Mario76-soldier/Mario_Keypad/README.md

# Mario_Keypad
This is applicated keypad such as ctrl+c and ctrl+v

## Cloning

This repository uses a git submodule for the key switch footprint library. Clone with:

```sh
git clone --recurse-submodules <this-repo-url>
```

If you already cloned without it:

```sh
git submodule update --init
```

## License

This repository contains code and design files under several licenses.
Each third-party component keeps its own license; the MIT license in [LICENSE](LICENSE) covers only this project's own work.

| Path | License | Copyright / Source |
|---|---|---|
| `Core/`, `USB_DEVICE/`, `STM32F103C8TX_FLASH.ld`, `Keypad.ioc` | [MIT](LICENSE) | © 2026 Mario76-soldier. Includes code generated by STM32CubeMX (© STMicroelectronics). Those files say they follow the LICENSE file in the root directory. |
| `Keypad_PCB/`, `LED.pretty/` | [MIT](LICENSE) | © 2026 Mario76-soldier. The PCB includes footprints from `keyswitches.pretty`, which stay under CC BY-SA 4.0 (see below). |
| `keyswitches.pretty/` (git submodule) | [CC BY-SA 4.0](https://creativecommons.org/licenses/by-sa/4.0/) | © daprice and contributors: <https://github.com/daprice/keyswitches.pretty> |
| `Drivers/STM32F1xx_HAL_Driver/` | [BSD-3-Clause](Drivers/STM32F1xx_HAL_Driver/LICENSE.txt) | © STMicroelectronics |
| `Drivers/CMSIS/Device/ST/` | [Apache-2.0](Drivers/CMSIS/Device/ST/STM32F1xx/LICENSE.txt) | © STMicroelectronics |
| `Drivers/CMSIS/` (Core) | [Apache-2.0](Drivers/CMSIS/LICENSE.txt) | © Arm Limited |
| `Middlewares/ST/STM32_USB_Device_Library/` | [ST Ultimate Liberty License SLA0044](https://www.st.com/SLA0044) | © STMicroelectronics |

### Third-party notices

- **keyswitches.pretty**: Mechanical keyboard switch footprints for KiCad by daprice, licensed under [Creative Commons Attribution-ShareAlike 4.0 International](https://creativecommons.org/licenses/by-sa/4.0/). If you modify and distribute these footprints, you must share them under the same license.
- **STM32Cube HAL / CMSIS / USB Device Library**: Provided by STMicroelectronics and Arm. The USB Device Library (SLA0044) may only be used on STMicroelectronics microcontrollers. See the license headers in each source file.
