Mario76-soldier/Mario_Keypad/Keypad_PCB/Keypad.kicad_pcb

## KiCad design Keypad_PCB/Keypad.kicad_pcb (2026-11-09)

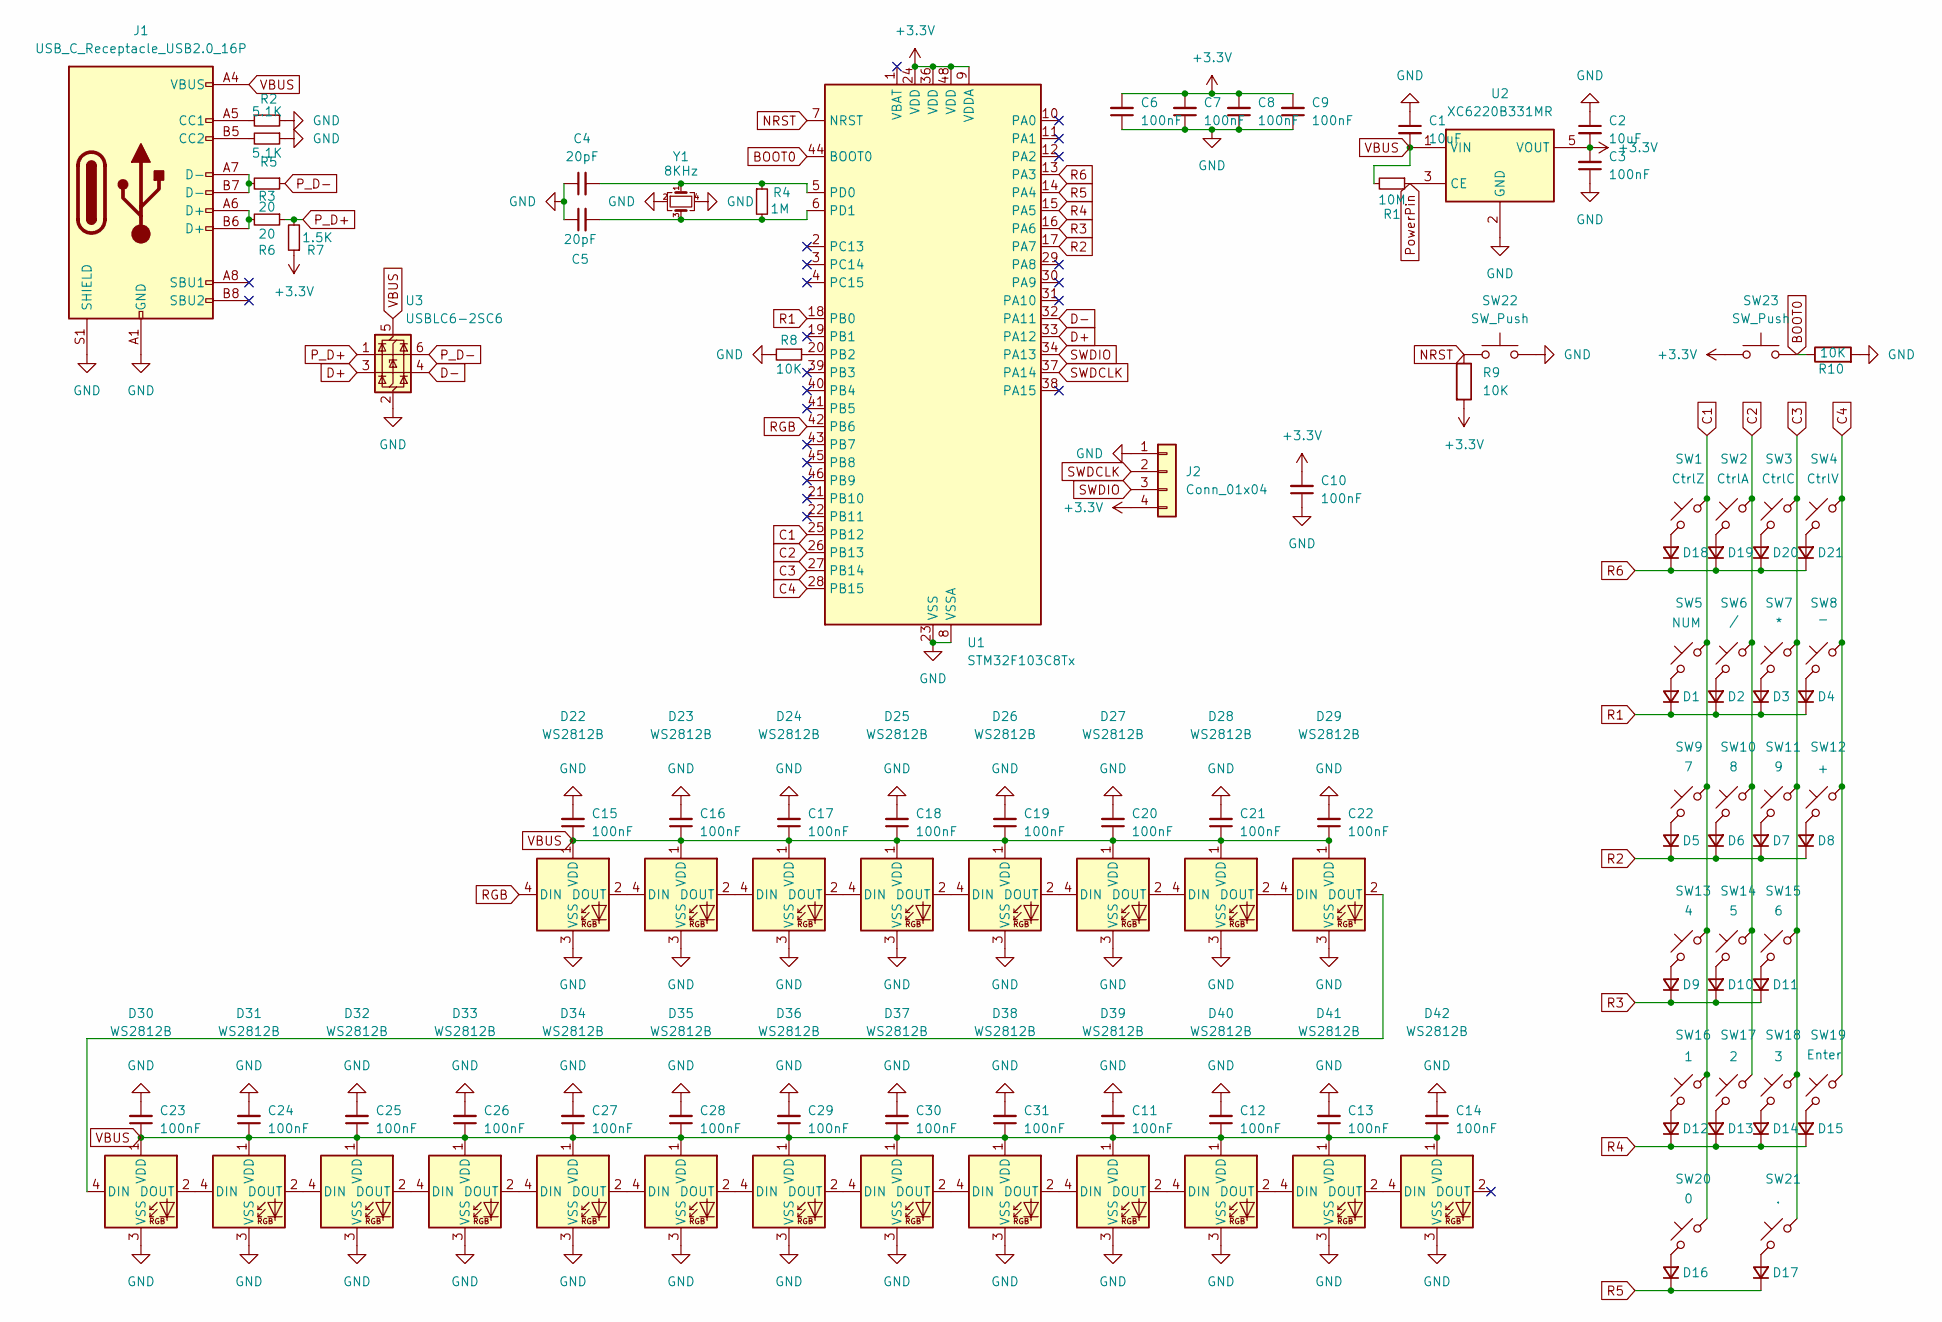
[picture p1: schematic Keypad.kicad_sch]

Parts:
C1, C2: 10uF; C_0603_1608Metric
C3, C6, C7, C8, C9, C10, C11, C12, C13, C14, C15, C16, C17, C18, C19, C20, C21, C22, C23, C24, C25, C26, C27, C28, C29, C30, C31: 100nF; C_0603_1608Metric
C4, C5: 20pF; C_0603_1608Metric
D1, D2, D3, D4, D5, D6, D7, D8, D9, D10, D11, D12, D13, D14, D15, D16, D17, D18, D19, D20, D21: D_Small; D_SOD-123
D22, D23, D24, D25, D26, D27, D28, D29, D30, D31, D32, D33, D34, D35, D36, D37, D38, D39, D40, D41, D42: WS2812B; WS2812_6028
J1: USB_C_Receptacle_USB2.0_16P; USB_C_Receptacle_HCTL_HC-TYPE-C-16P-01A
J2: Conn_01x04; PinHeader_1x04_P2.54mm_Vertical
R1: 10M; R_0603_1608Metric
R2, R3: 5.1K; R_0603_1608Metric
R4: 1M; R_0603_1608Metric
R5, R6: 20; R_0603_1608Metric
R7: 1.5K; R_0603_1608Metric
R8, R9, R10: 10K; R_0603_1608Metric
SW1: CtrlZ; Kailh_socket_MX
SW2: CtrlA; Kailh_socket_MX
SW3: CtrlC; Kailh_socket_MX
SW4: CtrlV; Kailh_socket_MX
SW5: NUM; Kailh_socket_MX
SW6: /; Kailh_socket_MX
SW7: *; Kailh_socket_MX
SW8: -; Kailh_socket_MX
SW9: 7; Kailh_socket_MX
SW10: 8; Kailh_socket_MX
SW11: 9; Kailh_socket_MX
SW12: +; Kailh_socket_MX
SW13: 4; Kailh_socket_MX
SW14: 5; Kailh_socket_MX
SW15: 6; Kailh_socket_MX
SW16: 1; Kailh_socket_MX
SW17: 2; Kailh_socket_MX
SW18: 3; Kailh_socket_MX
SW19: Enter; Kailh_socket_MX
SW20: 0; Kailh_socket_MX
SW21: .; Kailh_socket_MX
SW22, SW23: SW_Push; SW_Push_SPST_NO_Alps_SKRK
U1: STM32F103C8Tx; LQFP-48_7x7mm_P0.5mm
U2: XC6220B331MR; SOT-23-5
U3: USBLC6-2SC6; SOT-23-6
Y1: 8KHz; Crystal_SMD_3225-4Pin_3.2x2.5mm

Connections:
BOOT0: R10.1, SW23.2, U1.44 (BOOT0)
C1: SW1.2, SW5.2, SW9.2, SW13.2, SW16.2, SW20.2, U1.25 (PB12)
C2: SW2.2, SW6.2, SW10.2, SW14.2, SW17.2, U1.26 (PB13)
C3: SW3.2, SW7.2, SW11.2, SW15.2, SW18.2, SW21.2, U1.27 (PB14)
C4: SW4.2, SW8.2, SW12.2, SW19.2, U1.28 (PB15)
D+: U1.33 (PA12), U3.3 (I/O2)
D-: U1.32 (PA11), U3.4 (I/O2)
GND: C1.1, C2.1, C3.1, C4.1, C5.1, C6.1, C7.1, C8.1, C9.1, C10.1, C11.2, C12.2, C13.2, C14.2, C15.2, C16.2, C17.2, C18.2, C19.2, C20.2, C21.2, C22.2, C23.2, C24.2, C25.2, C26.2, C27.2, C28.2, C29.2, C30.2, C31.2, D22.3 (VSS), D23.3 (VSS), D24.3 (VSS), D25.3 (VSS), D26.3 (VSS), D27.3 (VSS), D28.3 (VSS), D29.3 (VSS), D30.3 (VSS), D31.3 (VSS), D32.3 (VSS), D33.3 (VSS), D34.3 (VSS), D35.3 (VSS), D36.3 (VSS), D37.3 (VSS), D38.3 (VSS), D39.3 (VSS), D40.3 (VSS), D41.3 (VSS), D42.3 (VSS), J1.A1 (GND), J1.A12 (GND), J1.B1 (GND), J1.B12 (GND), J1.S1 (SHIELD), J2.1, R2.1, R3.1, R8.2, R10.2, SW22.2, U1.8 (VSSA), U1.23 (VSS), U1.35 (VSS), U1.47 (VSS), U2.2 (GND), U3.2 (GND), Y1.2, Y1.4
NRST: R9.1, SW22.1, U1.7 (NRST)
unnamed: D1.2 (A), SW5.1
unnamed: D2.2 (A), SW6.1
unnamed: D3.2 (A), SW7.1
unnamed: D4.2 (A), SW8.1
unnamed: D5.2 (A), SW9.1
unnamed: D6.2 (A), SW10.1
unnamed: D7.2 (A), SW11.1
unnamed: D8.2 (A), SW12.1
unnamed: D9.2 (A), SW13.1
unnamed: D10.2 (A), SW14.1
unnamed: D11.2 (A), SW15.1
unnamed: D12.2 (A), SW16.1
unnamed: D13.2 (A), SW17.1
unnamed: D14.2 (A), SW18.1
unnamed: D15.2 (A), SW19.1
unnamed: D16.2 (A), SW20.1
unnamed: D17.2 (A), SW21.1
unnamed: D18.2 (A), SW1.1
unnamed: D19.2 (A), SW2.1
unnamed: D20.2 (A), SW3.1
unnamed: D21.2 (A), SW4.1
unnamed: D22.2 (DOUT), D23.4 (DIN)
unnamed: D23.2 (DOUT), D24.4 (DIN)
unnamed: D24.2 (DOUT), D25.4 (DIN)
unnamed: D25.2 (DOUT), D26.4 (DIN)
unnamed: D26.2 (DOUT), D27.4 (DIN)
unnamed: D27.2 (DOUT), D28.4 (DIN)
unnamed: D28.2 (DOUT), D29.4 (DIN)
unnamed: D29.2 (DOUT), D30.4 (DIN)
unnamed: D30.2 (DOUT), D31.4 (DIN)
unnamed: D31.2 (DOUT), D32.4 (DIN)
unnamed: D32.2 (DOUT), D33.4 (DIN)
unnamed: D33.2 (DOUT), D34.4 (DIN)
unnamed: D34.2 (DOUT), D35.4 (DIN)
unnamed: D35.2 (DOUT), D36.4 (DIN)
unnamed: D36.2 (DOUT), D37.4 (DIN)
unnamed: D37.2 (DOUT), D38.4 (DIN)
unnamed: D38.2 (DOUT), D39.4 (DIN)
unnamed: D39.2 (DOUT), D40.4 (DIN)
unnamed: D40.2 (DOUT), D41.4 (DIN)
unnamed: D41.2 (DOUT), D42.4 (DIN)
unnamed: J1.A5 (CC1), R2.2
unnamed: J1.B5 (CC2), R3.2
unnamed: J1.A6 (D+), J1.B6 (D+), R6.2
unnamed: J1.A7 (D-), J1.B7 (D-), R5.2
unnamed: R8.1, U1.20 (PB2)
unnamed: C4.2, R4.1, U1.5 (PD0), Y1.1
unnamed: C5.2, R4.2, U1.6 (PD1), Y1.3
P_D+: R6.1, R7.2, U3.1 (I/O1)
P_D-: R5.1, U3.6 (I/O1)
PowerPin: R1.1, U2.3 (CE)
R1: D1.1 (K), D2.1 (K), D3.1 (K), D4.1 (K), U1.18 (PB0)
R2: D5.1 (K), D6.1 (K), D7.1 (K), D8.1 (K), U1.17 (PA7)
R3: D9.1 (K), D10.1 (K), D11.1 (K), U1.16 (PA6)
R4: D12.1 (K), D13.1 (K), D14.1 (K), D15.1 (K), U1.15 (PA5)
R5: D16.1 (K), D17.1 (K), U1.14 (PA4)
R6: D18.1 (K), D19.1 (K), D20.1 (K), D21.1 (K), U1.13 (PA3)
RGB: D22.4 (DIN), U1.42 (PB6)
SWDCLK: J2.2, U1.37 (PA14)
SWDIO: J2.3, U1.34 (PA13)

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
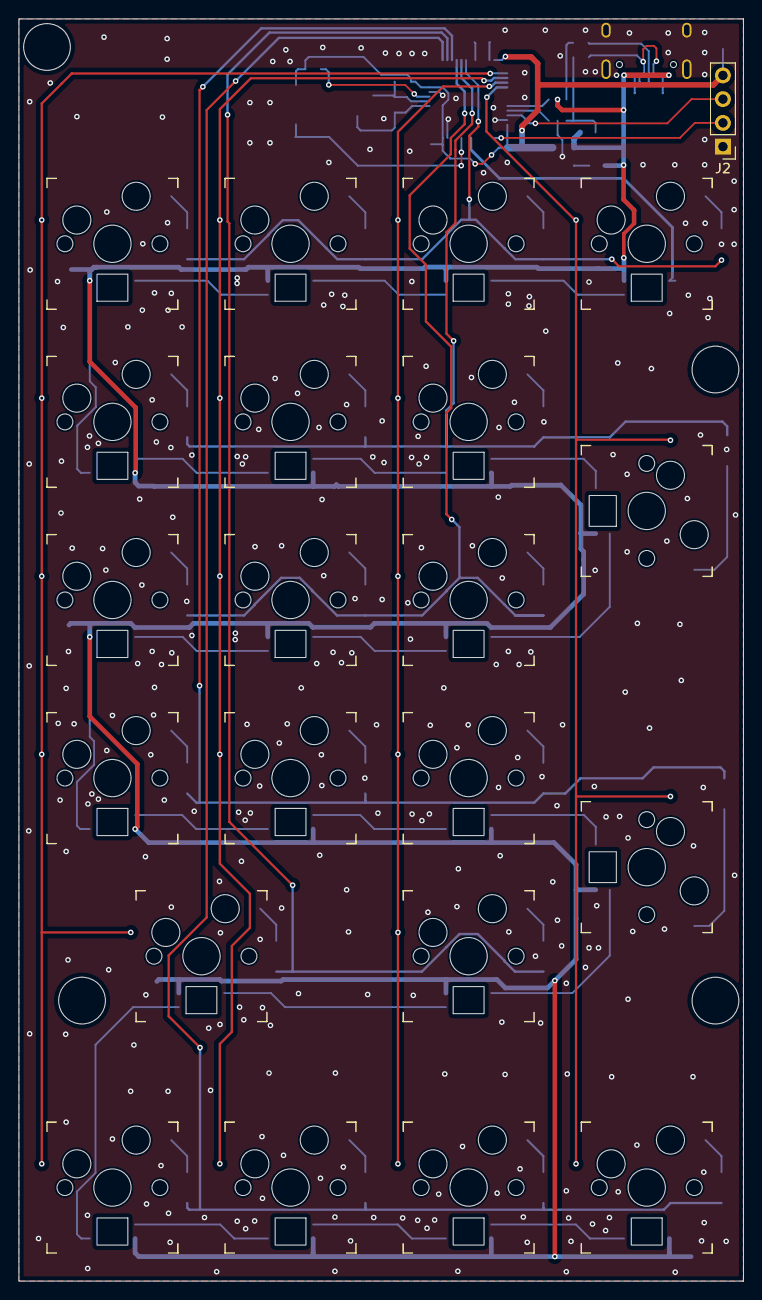
[picture p2: board Keypad.kicad_pcb from above]

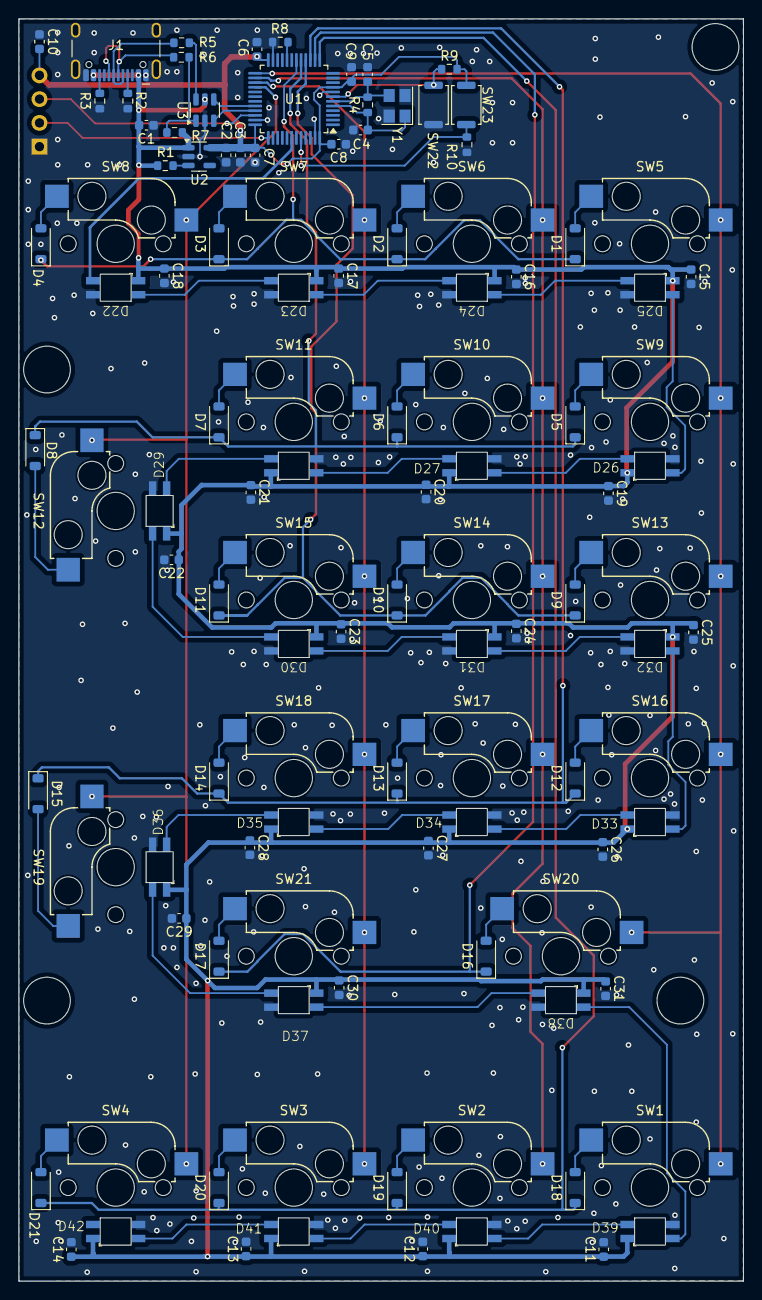
[picture p3: board Keypad.kicad_pcb from below]

Board: 2 copper layers, 77.5 x 135.0 mm, 112 parts (90 on the bottom side), 71 nets.
