Mario76-soldier/Mario_Keypad/Core/Src/main.c

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
/* Includes ------------------------------------------------------------------*/
#include "main.h"
#include "usb_device.h"

/* USER CODE BEGIN Includes */
#include "keypad.h"
#include "ws2812.h"
/* USER CODE END Includes */

TIM_HandleTypeDef htim2;
TIM_HandleTypeDef htim4;
DMA_HandleTypeDef hdma_tim4_ch1;

void SystemClock_Config(void);
static void MX_GPIO_Init(void);
static void MX_DMA_Init(void);
static void MX_TIM2_Init(void);
static void MX_TIM4_Init(void);
/**
  * @brief  The application entry point.
  * @retval int
  */
int main(void)
{

  /* MCU Configuration--------------------------------------------------------*/

  /* Reset of all peripherals, Initializes the Flash interface and the Systick. */
  HAL_Init();

  /* Configure the system clock */
  SystemClock_Config();

  /* Initialize all configured peripherals */
  MX_GPIO_Init();
  MX_DMA_Init();
  MX_USB_DEVICE_Init();
  MX_TIM2_Init();
  MX_TIM4_Init();
  /* USER CODE BEGIN 2 */
  HAL_TIM_Base_Start(&htim2);
  ws2812_init_t ws={
  		  .htim=&htim4,
  		  .hdma=&hdma_tim4_ch1
  };
  ws2812_start(&ws);
  /* USER CODE END 2 */

  /* Infinite loop */
  /* USER CODE BEGIN WHILE */
  while (1)
  {
    /* USER CODE END WHILE */

    /* USER CODE BEGIN 3 */
	Keypad_Scan();  // 약 1~5ms 간격
	HAL_Delay(2);   // 2ms 주기 권장
  }
  /* USER CODE END 3 */
}

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
/* USER CODE BEGIN 4 */
void delay_us(uint32_t us)
{
    __HAL_TIM_SET_COUNTER(&htim2, 0);  // 타이머 카운터를 0으로 초기화
    while (__HAL_TIM_GET_COUNTER(&htim2) < us);
}
/* USER CODE END 4 */
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
