Mario76-soldier/Mario_Keypad/Core/Inc/main.h

#define R5_Pin GPIO_PIN_3
#define R5_GPIO_Port GPIOA
#define R4_Pin GPIO_PIN_4
#define R4_GPIO_Port GPIOA
#define R3_Pin GPIO_PIN_5
#define R3_GPIO_Port GPIOA
#define R2_Pin GPIO_PIN_6
#define R2_GPIO_Port GPIOA
#define R1_Pin GPIO_PIN_7
#define R1_GPIO_Port GPIOA
#define R0_Pin GPIO_PIN_0
#define R0_GPIO_Port GPIOB
#define C1_Pin GPIO_PIN_12
#define C1_GPIO_Port GPIOB
#define C2_Pin GPIO_PIN_13
#define C2_GPIO_Port GPIOB
#define C3_Pin GPIO_PIN_14
#define C3_GPIO_Port GPIOB
#define C4_Pin GPIO_PIN_15
#define C4_GPIO_Port GPIOB
